soorajds25/Line-Following-Robot-v1/Images/image 2.jpg

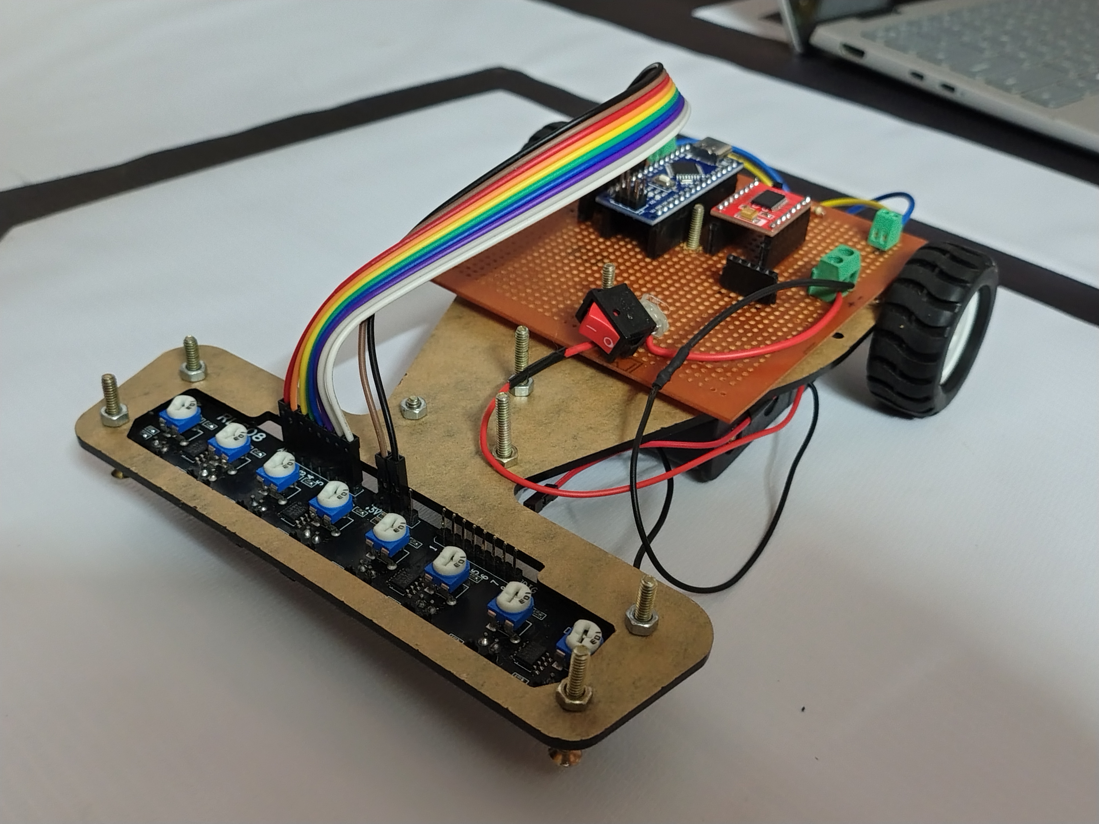
Images/image 2.jpg
