soorajds25/Line-Following-Robot-v1/Images/image 4.jpg

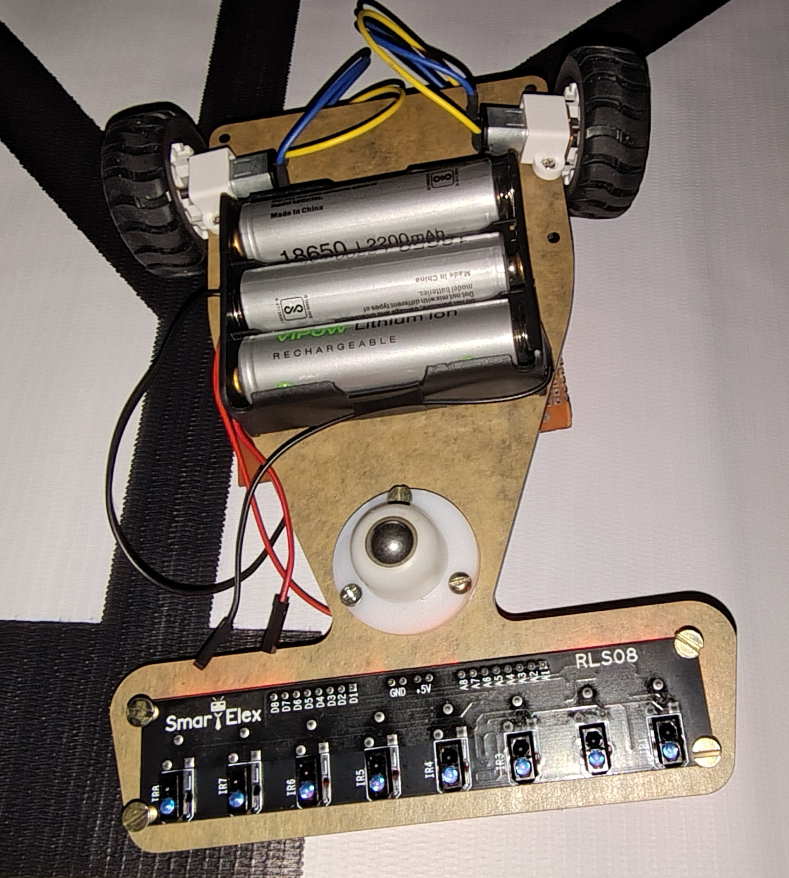
Images/image 4.jpg
