soorajds25/Line-Following-Robot-v1/README.md

# Line-Following-Robot-v1 (PID Controlled)

This project is a **PID-based Line Following Robot** built using an Arduino Nano, an 8-channel IR sensor array, and a TB6612FNG motor driver. It is designed for smooth and accurate line tracking with adjustable PID tuning.

---

## 🚀 Features

- 8-channel IR sensor array for precise line detection  
- PID control for smooth movement and correction  
- Start/Stop toggle button  
- Adjustable speed and PID constants  
- Handles line loss condition in a beginner friendly way 

---

## 🧰 Components Used

- Smartelex 8 Channel IR Sensor Array  
- Arduino Nano  
- TB6612FNG Motor Driver  
- Push Button  
- ON/OFF Switch  
- 3 × 3.7V 2200mAh 18650 Li-ion Batteries  
- Custom Laser-Cut Acrylic Chassis (2mm)  
- N20 Motors (12V, 600 RPM)  
- Wheels (high grip, compatible with N20 motors)  
- Castor Wheel  
- Battery Holder / Custom Battery Pack  
- Screw Terminals  
- 10K Ohm Resistor  

---

## 🔌 Pin Configuration

### Motor Driver (TB6612FNG)

| Function | Arduino Pin |
|---|---|
| AIN1 | 4 |
| AIN2 | 2 |
| BIN1 | 7 |
| BIN2 | 8 |
| PWMA | 5 |
| PWMB | 6 |
| STBY | 9 |

---

### Button

| Component | Arduino Pin |
|---|---|
| Push Button | 12 (INPUT_PULLUP) |

---

### IR Sensor Array

| Sensor Position | Arduino Pin |
|---|---|
| Left → Right | A0 → A7 |

---

## ⚙️ How It Works

### 1. Sensor Reading
- Each of the 8 IR sensors reads analog values.
- Low values (noise) are filtered.

### 2. Position Calculation
- Weighted average is used to determine line position:
- position = weighted_sum / total_sum
- Range: **0 (left) → 7000 (right)**  
- Center = **3500**

---

### 3. PID Control

Error is calculated as:
error = 3500 - position

PID components:

- **P (Proportional):** reacts to current error  
- **I (Integral):** accumulates past error  
- **D (Derivative):** predicts future error  

Final correction:
motor_speed = Kp * P + Ki * I + Kd * D

---

### 4. Motor Speed Adjustment
right_speed = base_speed + motor_speed
left_speed = base_speed - motor_speed

This creates turning behavior:
- If robot drifts right → left motor speeds up  
- If robot drifts left → right motor speeds up  

---

### 5. Line Loss Handling

If no sensor detects the line:

- Position is reset to center (3500)
- PID terms are reset
- Prevents unstable behavior

The reason I am using this method is since it is just a basic simple line follower, the chances of it interpreting it lost the line is very high eventhough it actually might not have lost it. So I have added a function which does the following as mentioned above :

```cpp
void get_position()
{
  if (sensors_sum == 0)  //This is the condition when there is no black line below it
  {
    // No line detected — reset PID terms and stop briefly
    integral = 0;
    derivative = 0;
    motorR.drive(0);
    motorL.drive(0);
    delay(50);
    return;
  }  //IF BLOCK containing the line loss code, you may comment this if you are having trouble with it
  position = sensors_average / sensors_sum;
}
```

I would also like to add one more thing, maybe something nobody told you till now. If you are a beginner and doing it for the first time, avoiding the line searching algorithm or code(which activates when you are above plain white area) is going to be huge life saver. I have seen many students build cool line following robots but only to get stuck in a loop of finding the line eventhough it is directly above the line. 

---

## 🔧 PID Tuning

Current values:

```cpp
float Kp = 0.09;
float Ki = 0.0;
float Kd = 0.15;

Tuning Guide
Increase Kp → faster response (may oscillate)
Increase Kd → smoother turns
Increase Ki → fixes steady offset (use cautiously)
```
## ▶️ Usage Instructions
- Upload the code to Arduino Nano
- Place robot on track
- Turn ON power switch
- Press button to start/stop

## ⚠️ Notes & Tips
- Ensure proper alignment of sensors (parallel to ground)
- Keep sensor height consistent (~5–10 mm from surface)
- Use good quality wheels for better grip
- Tune PID based on your track

## 🧪 Debugging

Use Serial Monitor:
```cpp
Serial.print("Position : ");
Serial.println(position);
```
Check:
- Sensor readings
- Position value
- Motor speeds

---

## 🔄 Future Improvements
- Add Bluetooth/WiFi tuning
- Auto PID tuning
- Speed boost on straight paths
- EEPROM storage for parameters
