soorajds25/Line-Following-Robot-v1/Circuit Diagram/Line_Following_Robot_V2.png

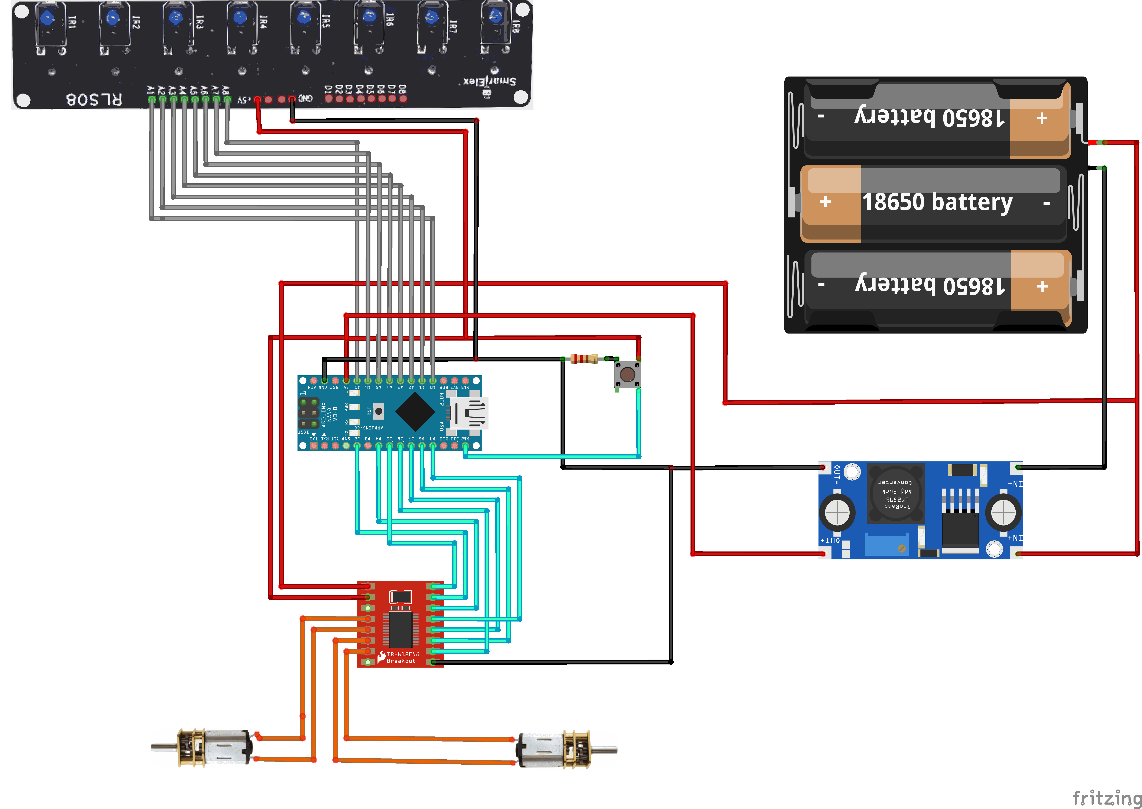
Circuit Diagram/Line_Following_Robot_V2.png
