soorajds25/Line-Following-Robot-v1/Images/image 1.jpg

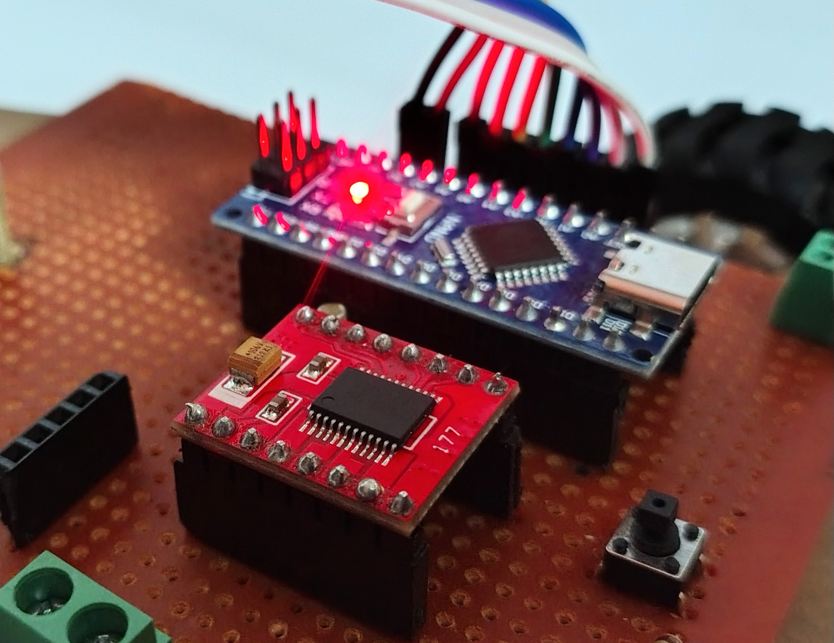
Images/image 1.jpg
