soorajds25/Line-Following-Robot-v1/Images/image 3.jpg

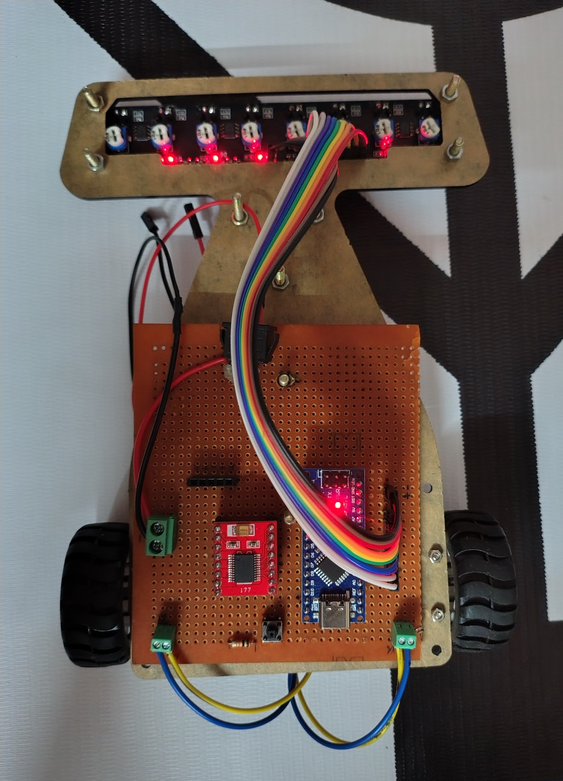
Images/image 3.jpg
