soorajds25/Line-Following-Robot-v1/Chassis/lfr chassis for laser cut v2.dxf

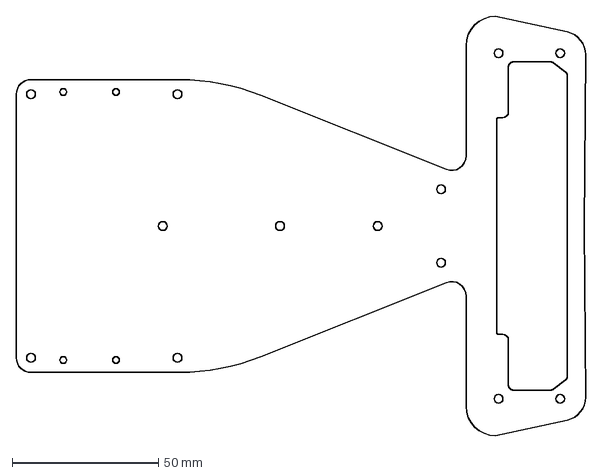
[picture p6: CAD file, 2026-04-08]
Chassis/lfr chassis for laser cut v2.dxf
194.4 x 143.1 mm
