soorajds25/Line-Following-Robot-v1/(list of files, cad)

Other CAD files:
Chassis/lfr chassis for laser cut v1.dwg
