soorajds25/Line-Following-Robot-v1/Chassis/lfr chassis for laser cut v1.pdf

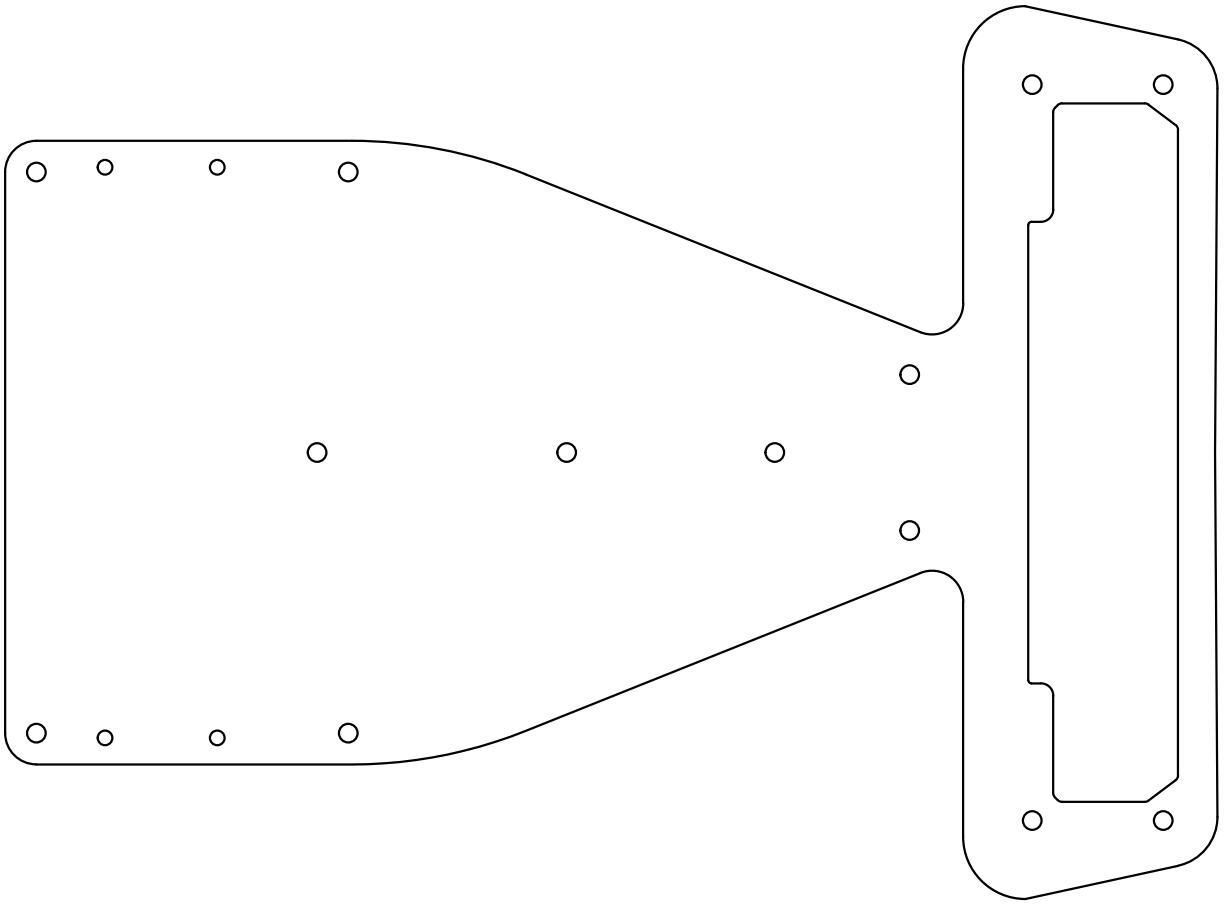
[picture p7: page 1]
