soorajds25/Line-Following-Robot-v1/(commit log)

2026-04-08 Initial commit adding all project files
    [lfr chassis for laser cut v1.dwg, lfr chassis for laser cut v2.dxf]
2026-04-12 adding the circuit diagram
